HZCS-IoT/Mechanics-walking-robot-/assets/video_frames/det_005.jpg

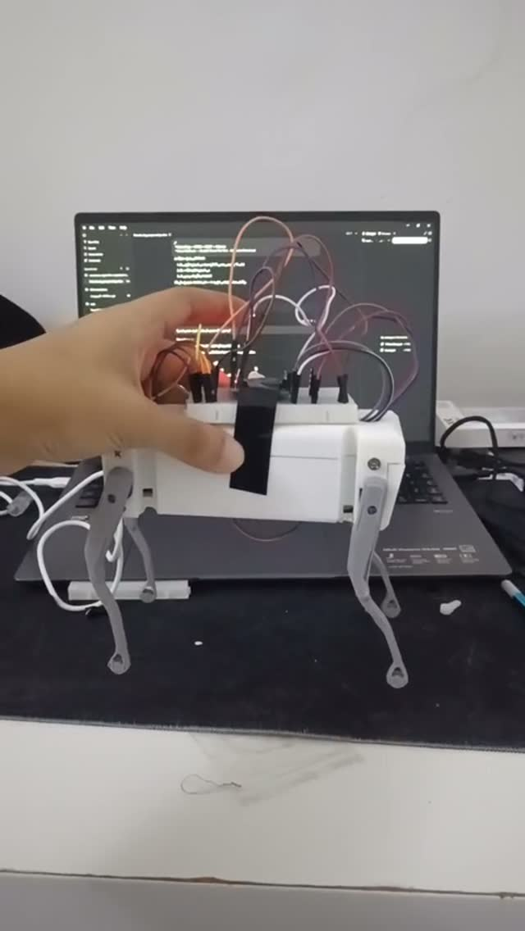
assets/video_frames/det_005.jpg
