HZCS-IoT/Mechanics-walking-robot-/assets/video_frames/det_001.jpg

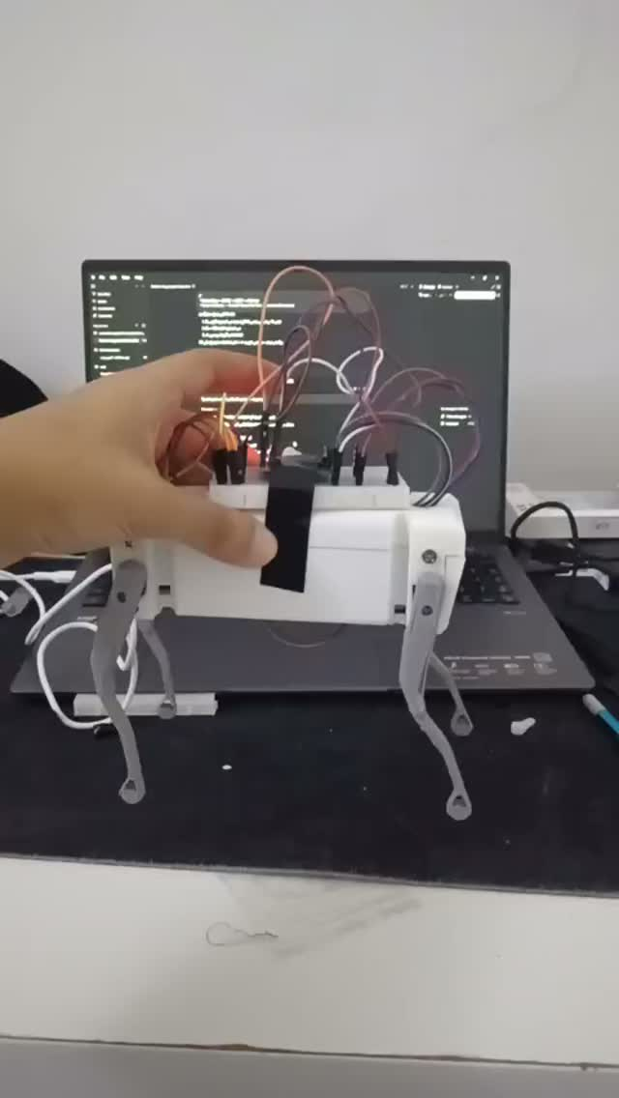
assets/video_frames/det_001.jpg
