HZCS-IoT/Mechanics-walking-robot-/README.md

<div align="center">

# Mechanics — Walking Robot
## RoboDog BodyV2 · ESP32 + MQTT




**Smart Methods — الأساليب الذكية · 2026**

كلب رباعي الأرجل (4× SG90) — مشي · مصافحة · تحكم جوال/صوت

</div>

---

## 📄 الدليل الكامل

**[docs/robodog/README.md](docs/robodog/README.md)** — شرح من الألف للياء + **13 خطوة للتقليد**

| | |
|--|--|
| **تبي تسوي زيي؟** | [خطوات التقليد](docs/robodog/README.md#2-️-تبي-تسوي-زيي--خطوات-التقليد) |
| **تحكم جوال / لابتوب** | [خطوات اللوحة](docs/robodog/README.md#7-لوحة-التحكم-control-panel) |
| Firmware | [`esp32/robodog_mqtt/`](esp32/robodog_mqtt/) |
| Control Panel | [`web/h/`](web/h/) — [README](web/h/README.md) → `h/` على InfinityFree |
| Docs | [`docs/robodog/README.md`](docs/robodog/README.md) — **19 قسم** |
| **تشبيك ESP32** | [YouTube ↗](https://youtu.be/DsWuTCv1QBQ) |

> **ملاحظة:** المشي **بطء** — **لا grip** في الأقدام → اضغط «أمام» **عدة مرات**.  
> **طاقة:** المشي يحرّك **2 سيرفو** في كل خطوة — تشغيل 2 للاختبار **آمن** ([شرح](docs/robodog/README.md#3-المكونات-والتشبيك)).

---

## 📁 هيكل المستودع

```
Mechanics-walking-robot-/
├── esp32/
│   ├── robodog_mqtt/       ← Firmware النهائي ★
│   ├── robodog_calibrate/  ← معايرة neutral
│   ├── servo_one_io16/     ← اختبار سيرفو واحد
│   └── ...
├── web/h/                  ← لوحة التحكم (InfinityFree) ★
│   ├── index.html
│   ├── manual.html
│   ├── voice.html
│   ├── css/
│   └── js/
└── docs/robodog/           ← التوثيق ★
    ├── README.md
    ├── 01-CODE.md
    ├── 02-MQTT.md
    ├── 03-CONTROL-PANEL.md
    ├── 04-TROUBLESHOOTING.md
    └── 05-ESP32-LEDC.md
```

---

## 🚀 البدء السريع

```bash
git clone https://github.com/HZCS-IoT/Mechanics-walking-robot-.git
```

1. اقرأ [`docs/robodog/README.md`](docs/robodog/README.md)
2. شبّك حسب [فيديو YouTube](https://youtu.be/DsWuTCv1QBQ)
3. عدّل WiFi في `esp32/robodog_mqtt/robodog_mqtt.ino` → Upload
4. ارفع `web/h/` على InfinityFree
5. **جوال أو لابتوب:** افتح `https://webtask1.free.je/h/index.html?v=6`

---

<p align="center">
  <b>Smart Methods — RoboDog BodyV2</b><br>
  <i>ESP32 · MQTT · LEDC · Control Panel · Voice</i>
</p>
