HZCS-IoT/Mechanics-walking-robot-/assets/reference-images/README.md

# مراجع بصرية

## الجزء الأول — مشروع العام (بحث)

| روبوت | الرابط |
|---|---|
| Boston Dynamics Spot | https://bostondynamics.com/products/spot/ |
| Unitree Go1 | https://www.unitree.com/products/go1 |
| Stanford Doggo | https://github.com/Nate711/StanfordDoggoProject |
| SpotMicro | https://www.thingiverse.com/thing:3445283 |

## الجزء الثاني — Onshape (BodyV2)

| المورد | الرابط |
|---|---|
| Onshape Assembly | https://cad.onshape.com/documents/b26f18ef0000550a5887d678/w/48a6352dd9256db373579cc0/e/41e000305039f0b434641ddc |
| YouTube Video | https://youtu.be/dGe0Nn-FiPE |

---

[← README](../../README.md)
