HZCS-IoT/Mechanics-walking-robot-/assets/video_frames/det_009.jpg

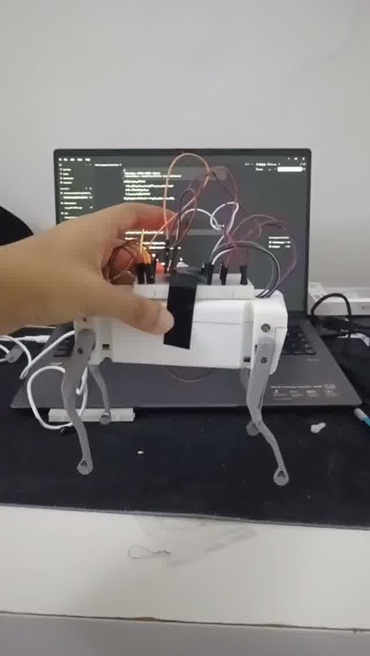
assets/video_frames/det_009.jpg
