HZCS-IoT/Mechanics-walking-robot-/assets/video_frames/det_022.jpg

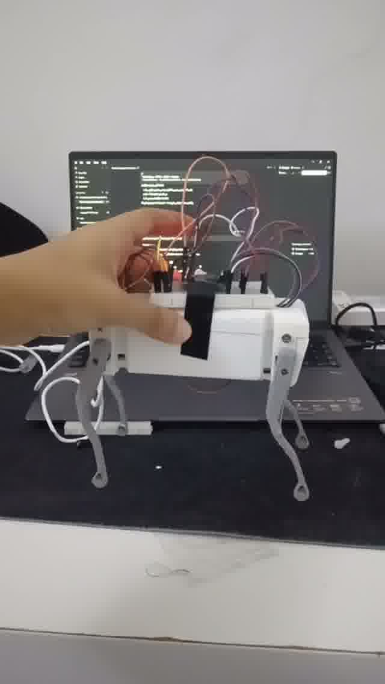
assets/video_frames/det_022.jpg
