HZCS-IoT/Mechanics-walking-robot-/assets/video_frames/det_023.jpg

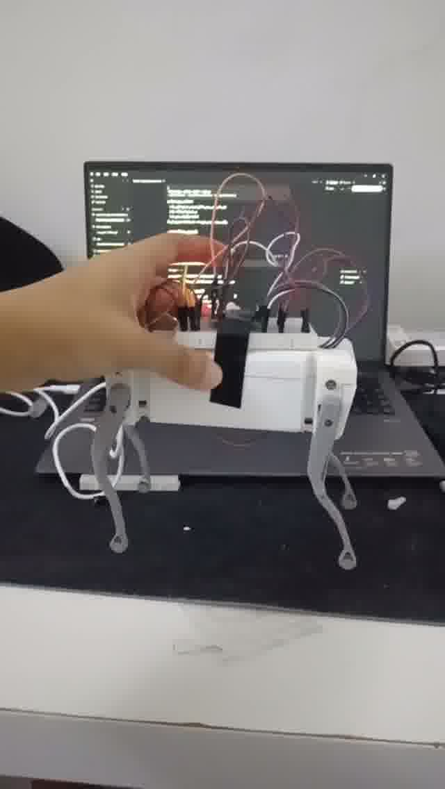
assets/video_frames/det_023.jpg
