HZCS-IoT/Mechanics-walking-robot-/assets/video_frames/det_026.jpg

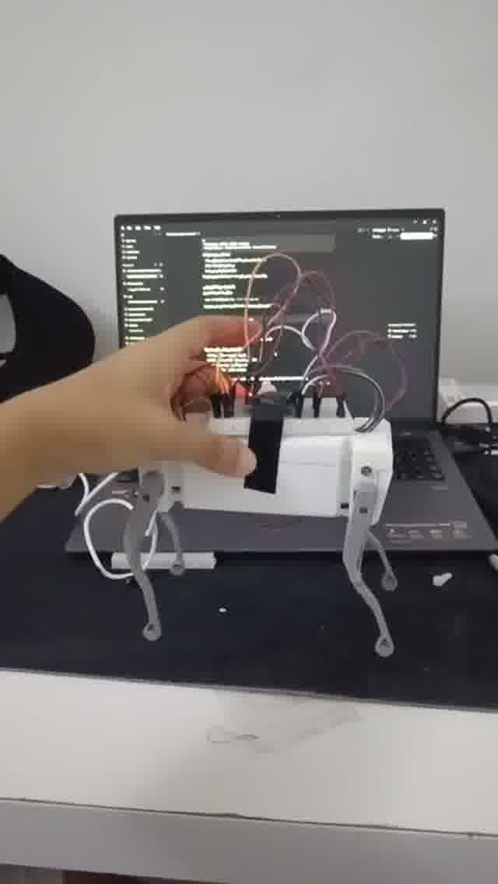
assets/video_frames/det_026.jpg
