HZCS-IoT/Mechanics-walking-robot-/assets/video_frames/det_028.jpg

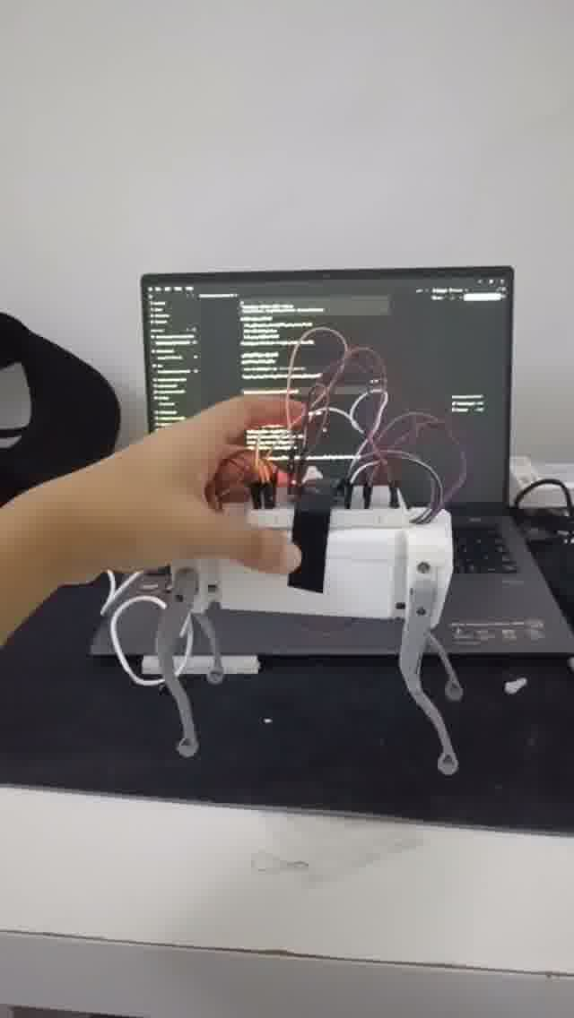
assets/video_frames/det_028.jpg
