HZCS-IoT/Mechanics-walking-robot-/assets/video_frames/det_029.jpg

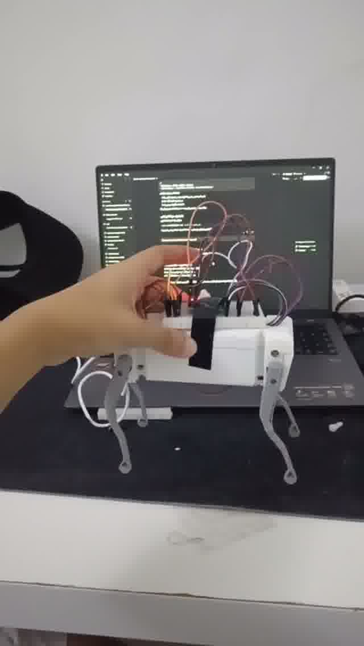
assets/video_frames/det_029.jpg
