HZCS-IoT/Mechanics-walking-robot-/assets/video_frames/det_030.jpg

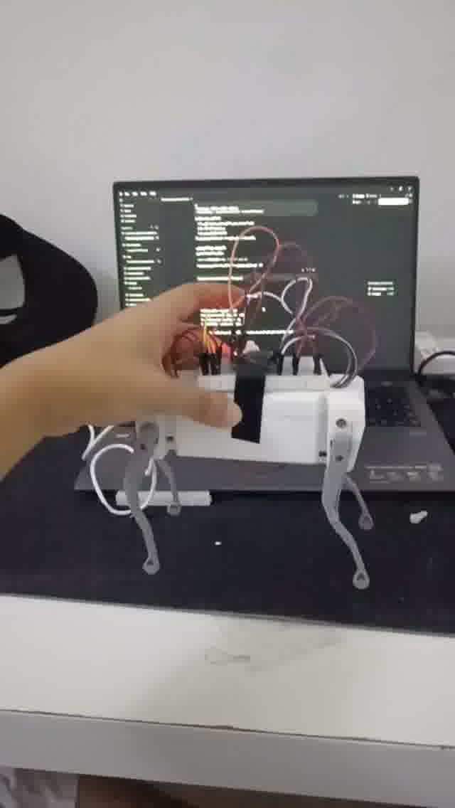
assets/video_frames/det_030.jpg
