HZCS-IoT/Mechanics-walking-robot-/(commit log)

2026-08-06 Add RoboDog BodyV2: ESP32 firmware, MQTT control panel, and full A-Z documentation.
    Includes voice/manual web panel, gait and handshake logic, troubleshooting guides, and YouTube demo links.
2026-08-06 Remove WiFi credentials and add explanatory comments across firmware and panel JS.
    Replace SSID/password with placeholders so followers can configure their own network safely.
    [robodog_control.ino, robodog_mqtt.ino]
2026-08-06 Make walking-robot repo standalone: dedicated README and robodog docs only.
    Remove Task 1/2 algorithm files from this repository — those stay in mechanics-Algorithm-exploded-view-.
2026-08-08 Add wiring YouTube link, 2-servo power note, and laptop vs phone control steps.
    Clarify replication path for followers using InfinityFree panel from mobile or desktop.
2026-08-08 Fix doc typos after wiring and control panel updates
2026-08-08 Expand MQTT guide with step-by-step ESP32 and panel connection instructions.
    Add verification steps, MQTT Explorer test, and troubleshooting table.
2026-08-08 Expand robodog docs with full explanations for every step and file.
    Add web/h README, helper sketches guide, and detailed MQTT, panel, LEDC, and troubleshooting sections so followers know exactly what to upload and where.
